riabayonaor1/jaquebot-manual/assets/assembly/fx12.jpg

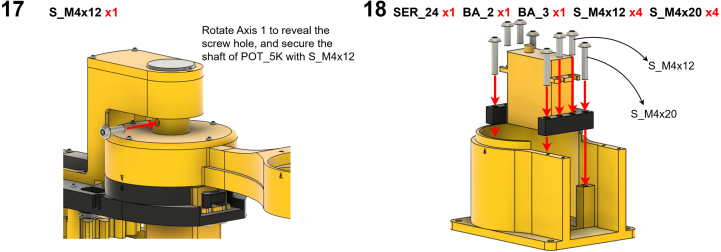
assets/assembly/fx12.jpg
