riabayonaor1/jaquebot-manual/assets/assembly/fx5.jpg

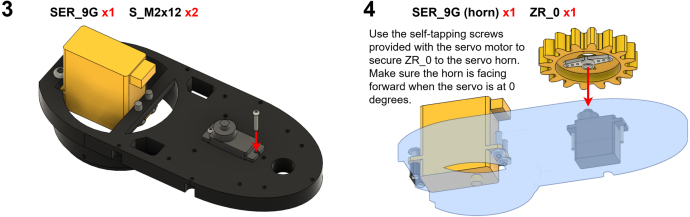
assets/assembly/fx5.jpg
