riabayonaor1/jaquebot-manual/downloads/JaqueBot_ArUco_40_1a1.pdf

# JaqueBot | ArUco DICT_4X4_1000

Imprimir al 100 %, sin ajustar a pagina. Comprobar regla de 50 mm.

Piezas: corte circular 11 mm / negro 5,4 mm. Referencias: 16 mm / negro 12 mm.

Dimensiones del CAD R03 conservadas en R04 / R04 M3. No modificar las figuras.

ID 100

a8 / superior izquierda

ID 101

h8 / superior derecha

ID 102

h1 / inferior derecha

ID 103

a1 / inferior izquierda

ID 104

Reserva / sin plataforma adicional

ID 105

Reserva / sin plataforma adicional

ID 106

Reserva / sin plataforma adicional

ID 107

Reserva / sin plataforma adicional

ID 201 / a7 | ID 202 / b7 | ID 203 / c7 | ID 204 / d7 | ID 205 / e7 | ID 206 / f7 | ID 207 / g7 | ID 208 / h7
ID 209 / a8 | ID 210 / h8 | ID 211 / b8 | ID 212 / g8 | ID 213 / c8 | ID 214 / f8 | ID 215 / d8 | ID 216 / e8
ID 301 / a2 | ID 302 / b2 | ID 303 / c2 | ID 304 / d2 | ID 305 / e2 | ID 306 / f2 | ID 307 / g2 | ID 308 / h2
ID 309 / a1 | ID 310 / h1 | ID 311 / b1 | ID 312 / g1 | ID 313 / c1 | ID 314 / f1 | ID 315 / d1 | ID 316 / e1

104-107 son reservas: el tablero existente solo tiene cuatro plataformas de referencia.

Control de escala: esta linea debe medir exactamente 50 mm.

Recortar sobre el contorno gris; conservar el margen blanco. Papel mate y adhesivo fino.

Ajuste y lectura por la camara real pendientes de comprobar. Reemplazar etiquetas antiguas.
