riabayonaor1/jaquebot-manual/downloads/QR_JaqueBot.pdf

PROYECTO GRADO 11C · 2026

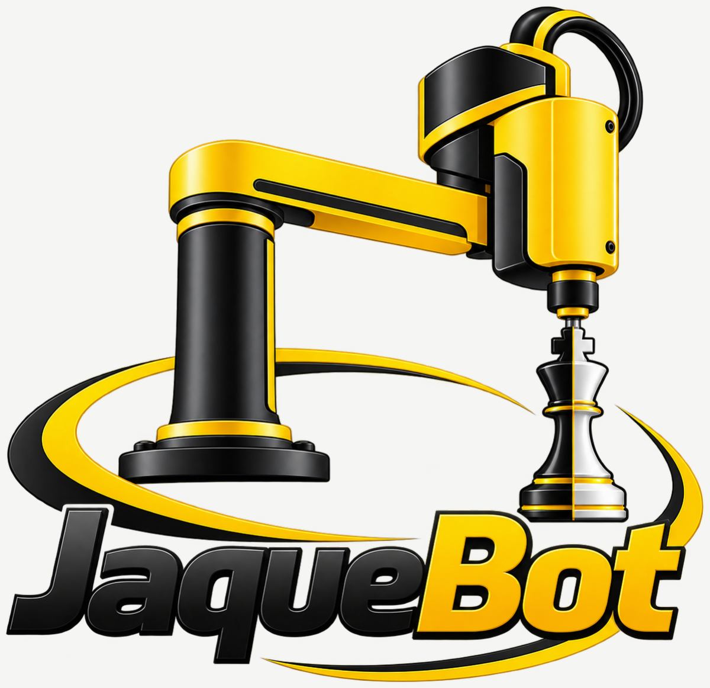
[picture p10: figure]

# Explora JaqueBot

Gira el robot. Selecciona una pieza. Aprende.

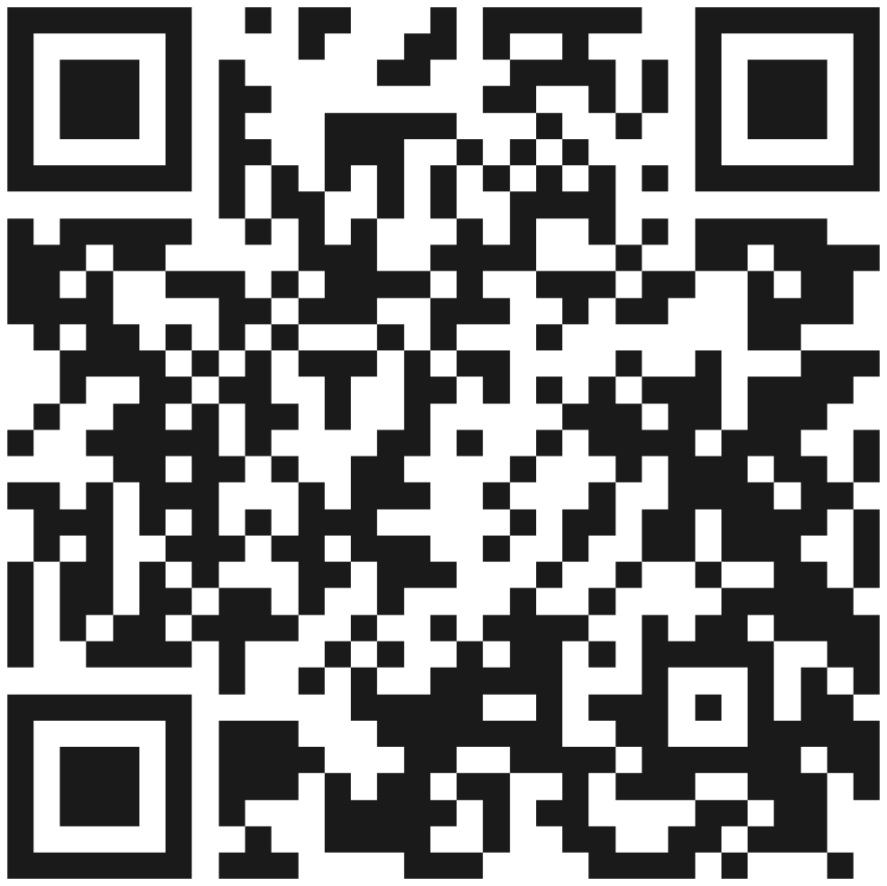
[picture p11: figure]

## ESCANEA CON LA CÁMARA DEL TELÉFONO

### Modelo 3D interactivo · Dos aplicaciones · Conexiones Cómo se construyó · Manual PDF y planos descargables

riabayonaor1.github.io/jaquebot-manual

Colegio Carlos Julio Torrado Peñaranda
JaqueBot · plataforma mecánica EduSCARA · edición 16 de octubre de 2026
