riabayonaor1/jaquebot-manual/assets/illustrations/plan-ink.png

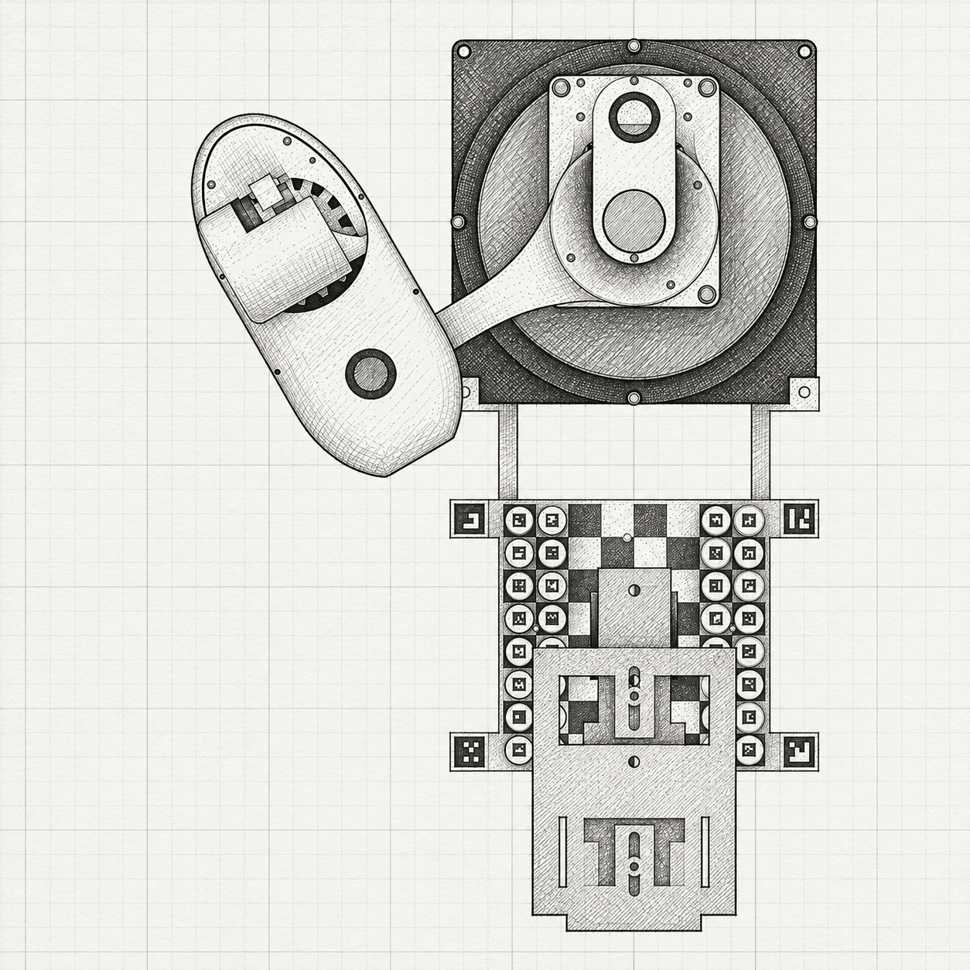
assets/illustrations/plan-ink.png
