riabayonaor1/jaquebot-manual/assets/illustrations/raspberry-pi-5-ink.png

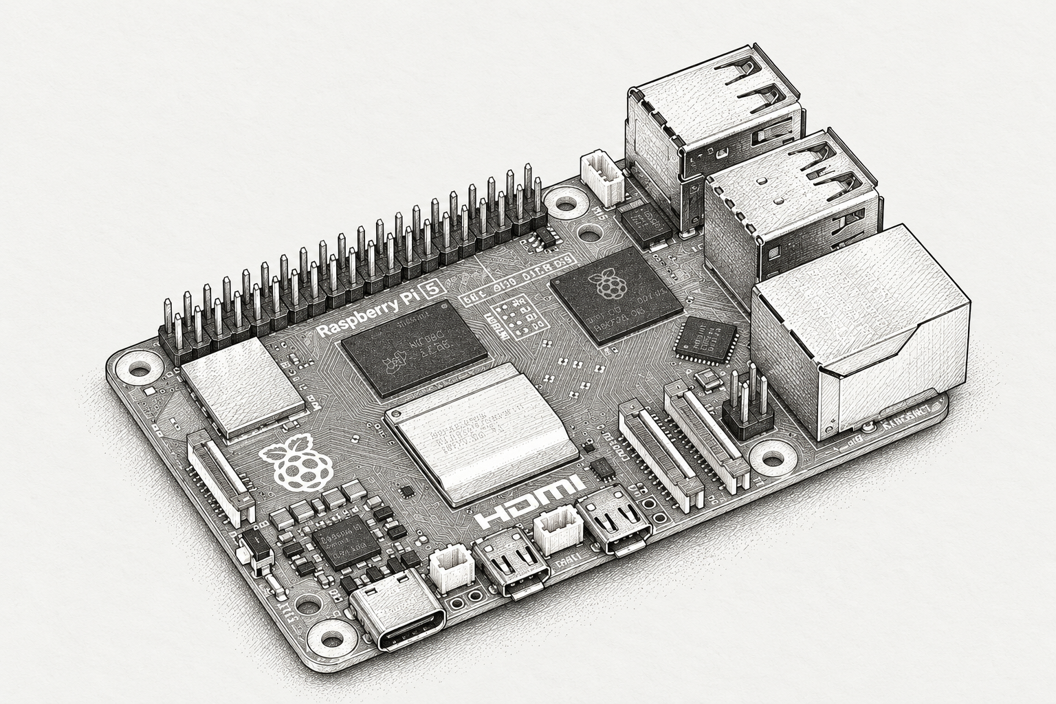
assets/illustrations/raspberry-pi-5-ink.png
