riabayonaor1/jaquebot-manual/assets/illustrations/raspberry-pi-ai-camera-ink.png

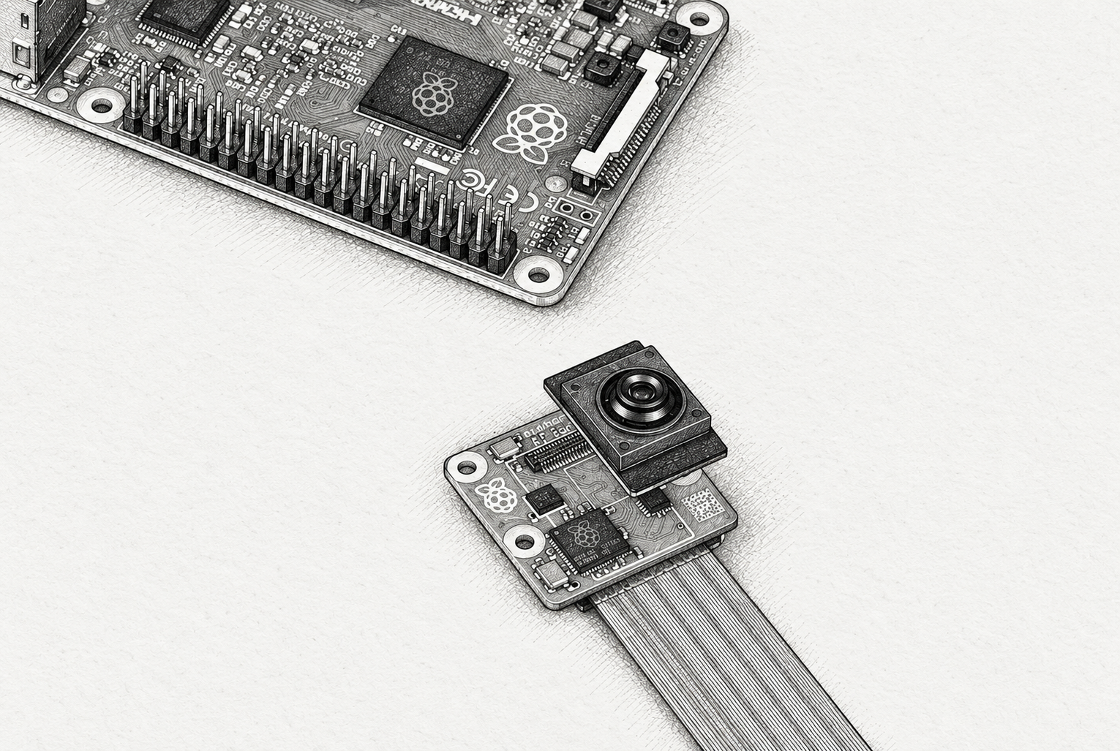
assets/illustrations/raspberry-pi-ai-camera-ink.png
