riabayonaor1/jaquebot-manual/assets/reference/chess-app.jpg

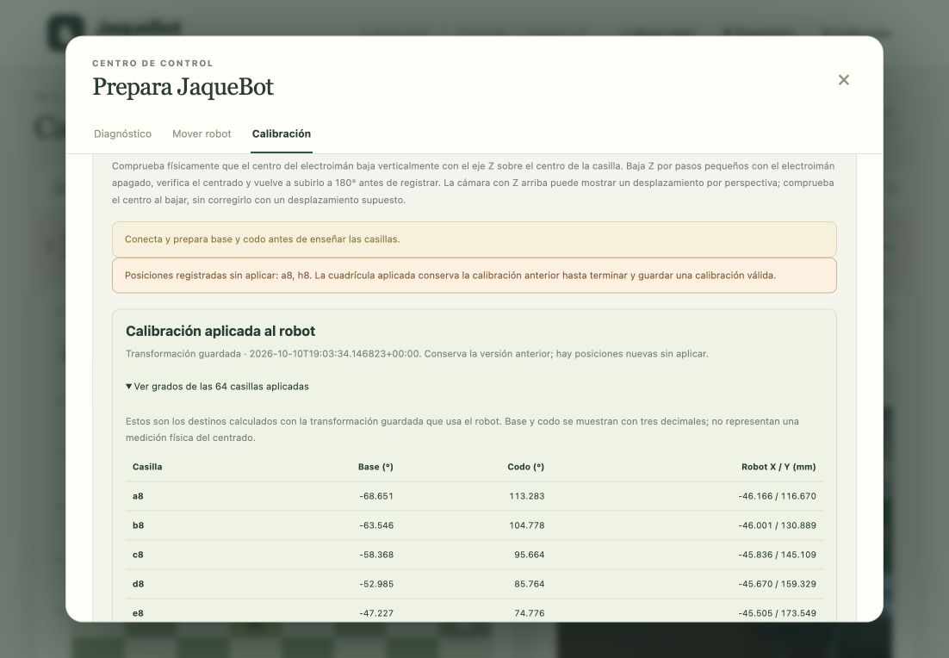
assets/reference/chess-app.jpg
