riabayonaor1/jaquebot-manual/assets/reference/electroiman.png

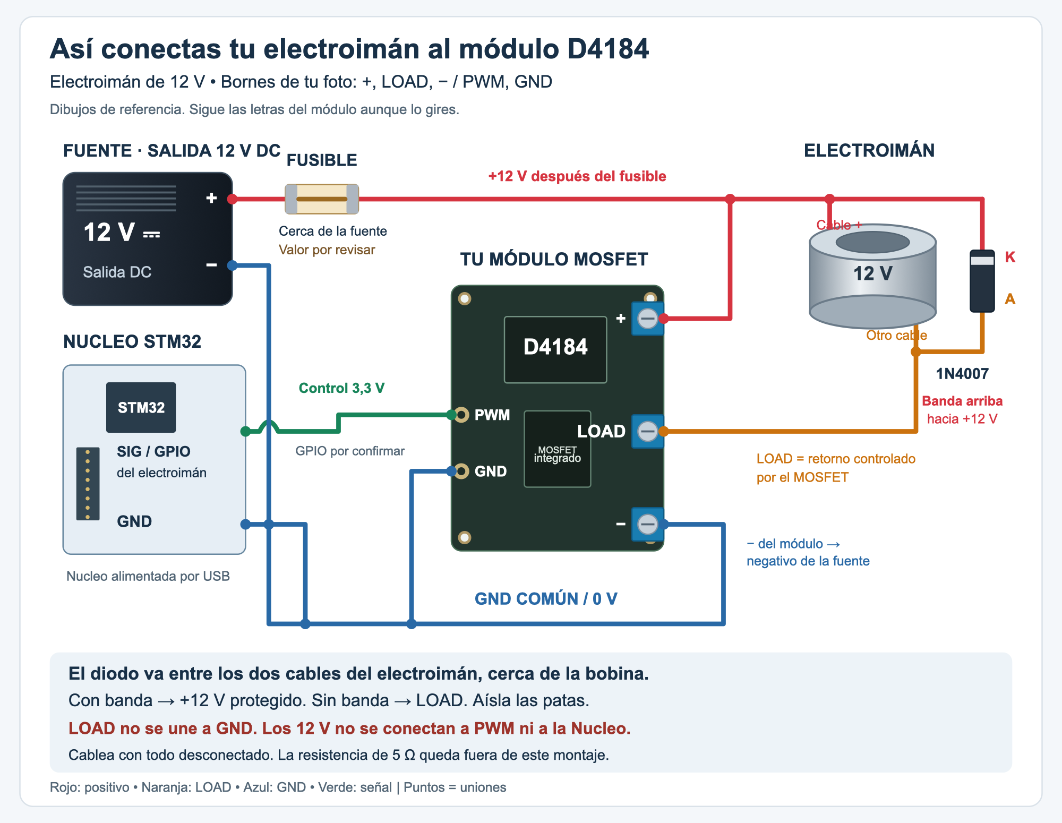
assets/reference/electroiman.png
