riabayonaor1/jaquebot-manual/assets/reference/jaquebot-ajedrez-inicio-real-2026-10-11.jpg

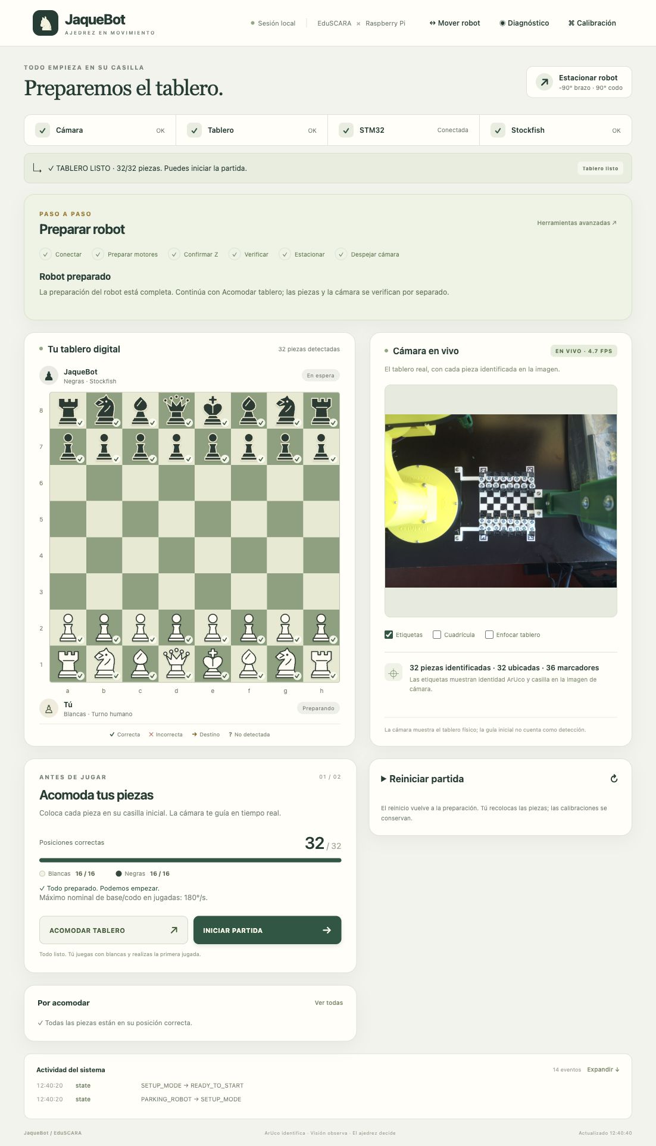
assets/reference/jaquebot-ajedrez-inicio-real-2026-10-11.jpg
