riabayonaor1/jaquebot-manual/assets/reference/nucleo-pines.png

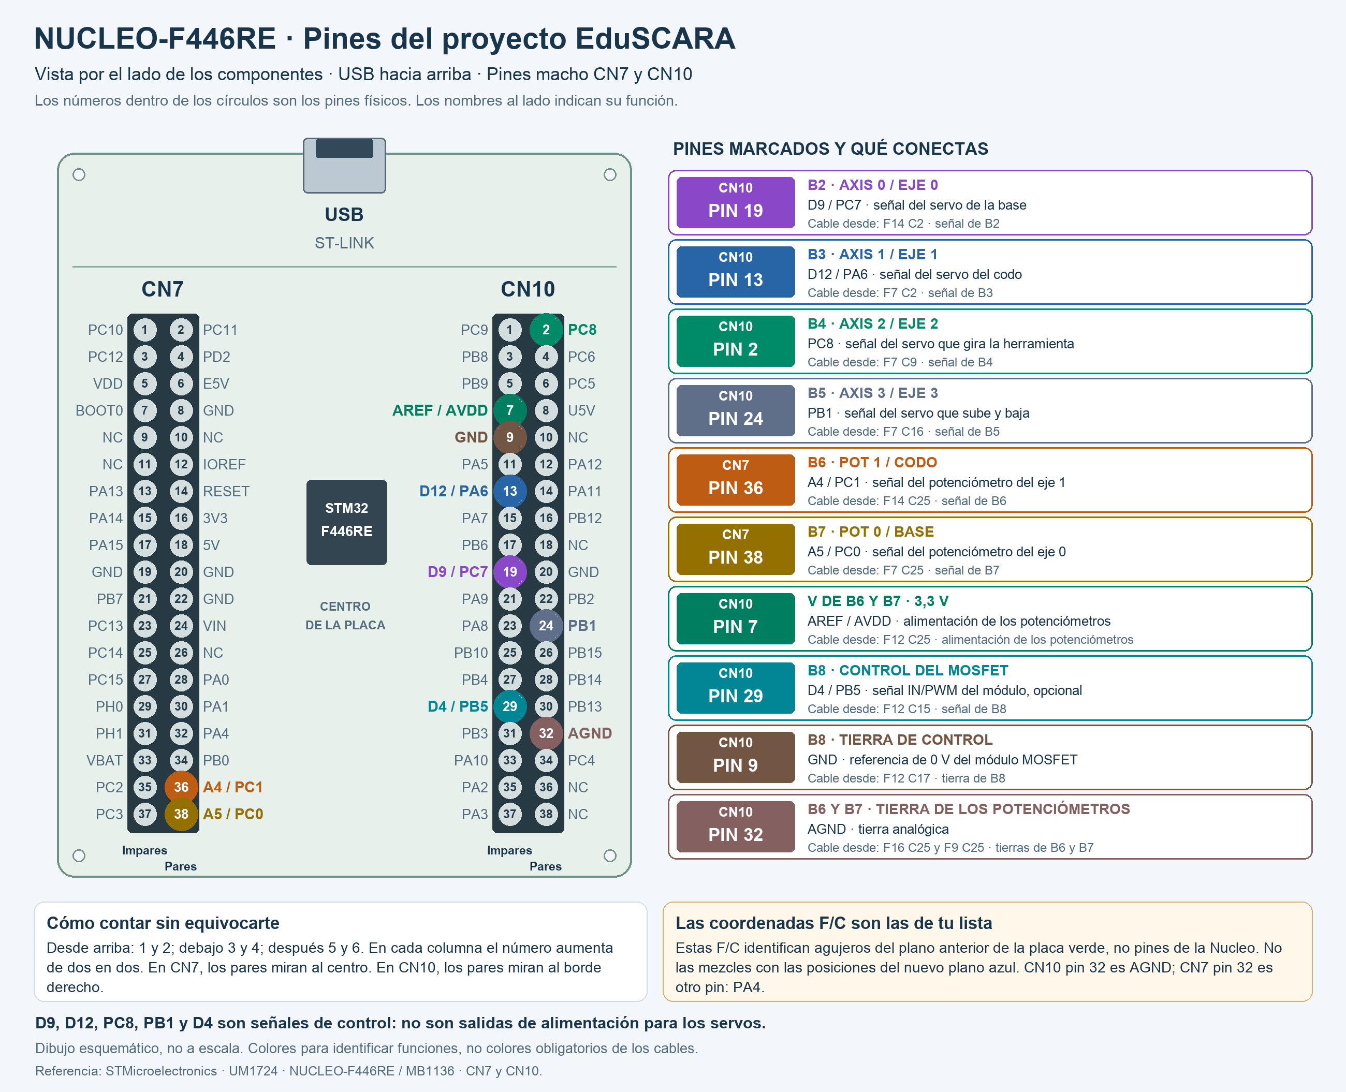
assets/reference/nucleo-pines.png
