riabayonaor1/jaquebot-manual/assets/reference/visor-jaquebot.png

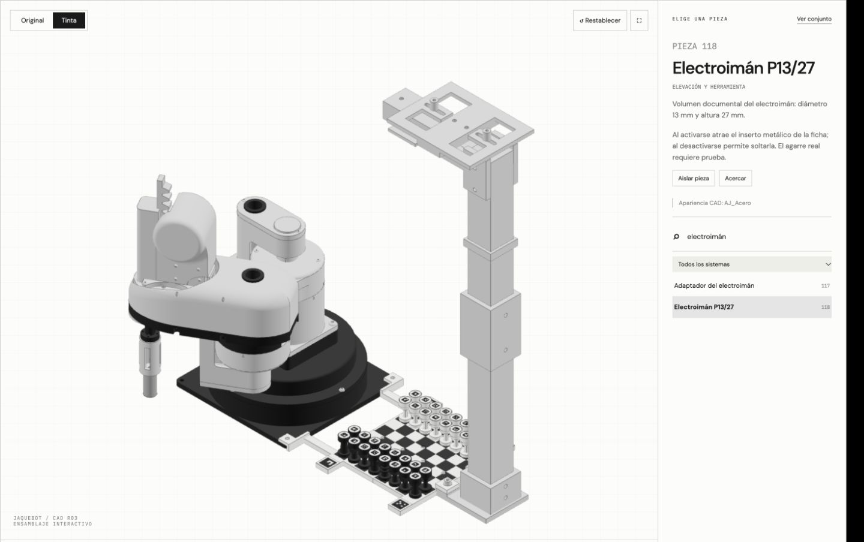
assets/reference/visor-jaquebot.png
