riabayonaor1/jaquebot-manual/(list of files, cad)

Other CAD files:
downloads/EduSCARA_Ajedrez_R03.f3d
