riabayonaor1/jaquebot-manual/assets/assembly/fx7.jpg

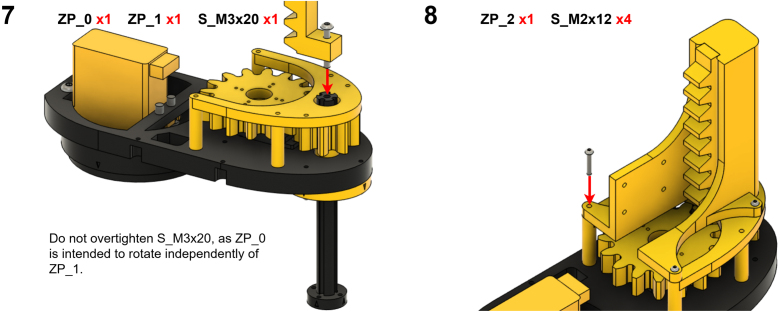
assets/assembly/fx7.jpg
