riabayonaor1/jaquebot-manual/assets/qr-manual.png

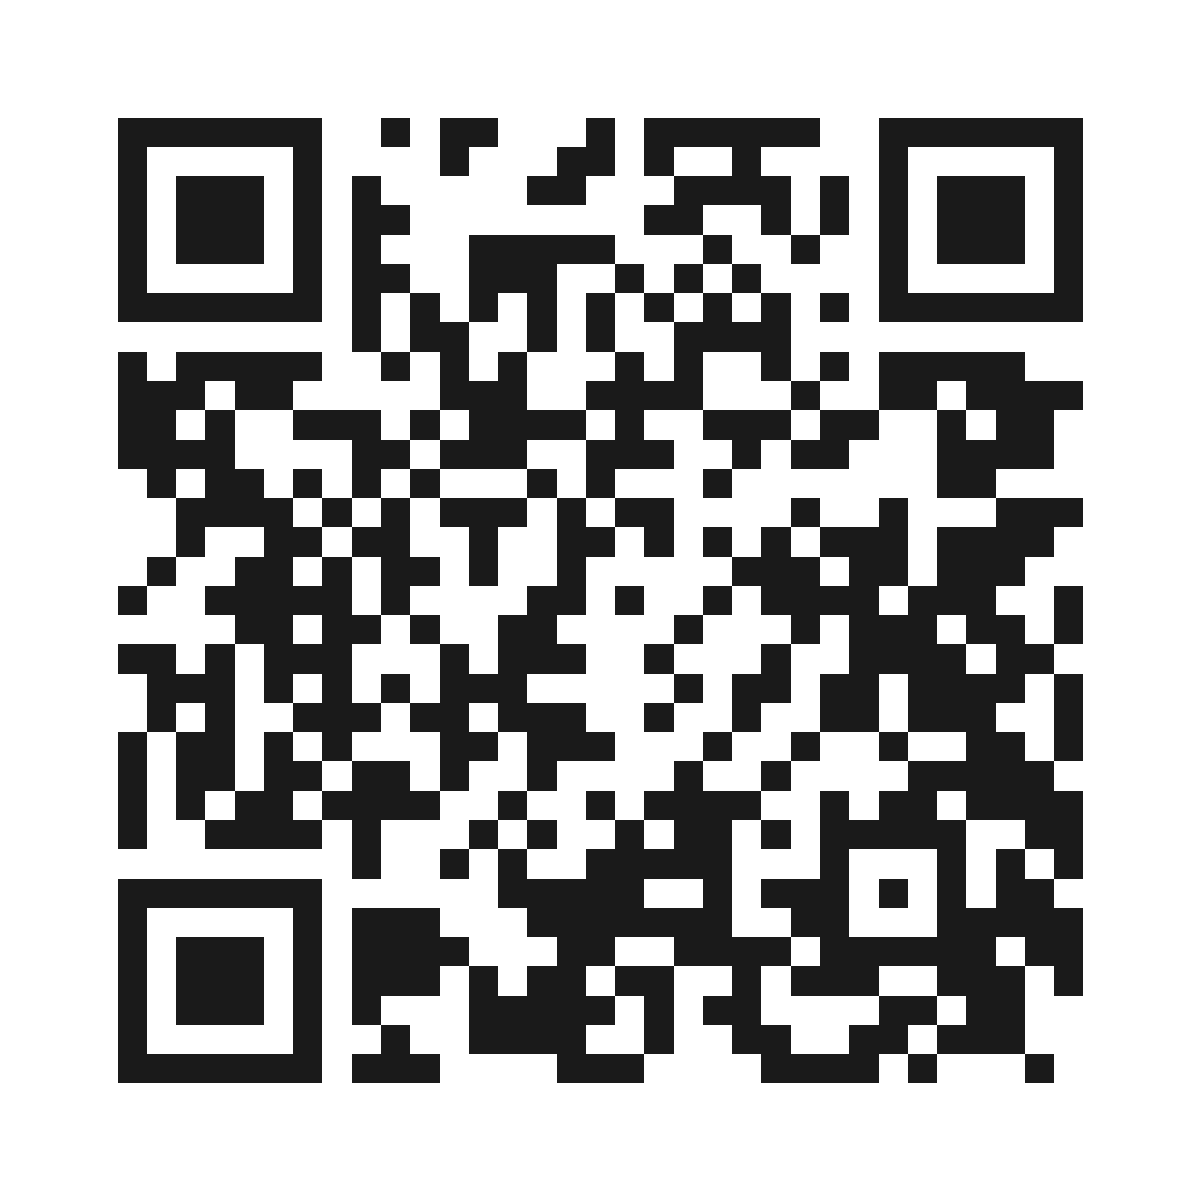
assets/qr-manual.png
