riabayonaor1/jaquebot-manual/(commit log)

2026-10-13 Publicar manual interactivo JaqueBot para GitHub Pages
    [EduSCARA_Ajedrez_R03.f3d]
2026-10-16 Expand JaqueBot guide with materials, assembly and app walkthroughs
